camcamfresh/Xiaomi-M365-BLE-Controller-Replacement/(threads)

Thread 1 (2018-08-11):

Question about the pinout to the Particle

pilotdeveloper, 2018-08-11:
How are you connecting this to your particle board?

I've got one and am able to test it too :)

camcamfresh, 2018-08-11:
turn on half duplex mode on the particle board, connect the yellow data wire from scooter to the serial's TX line and make sure to connect the ground too! after that it should programming like any normal system.

pilotdeveloper, 2018-08-11:
No need for a pull-up resistor and connection to RX?

Also, I'm going to open a branch with some additional screen support.

camcamfresh, 2018-08-12:
That's a good question. I'm not too sure. To the best of my knowledge it is not necessary, but I might be wrong. I think the pull up/down resistor just prevents unwanted noise when the line is not in use like during a reset or something. Although since it uses half duplex, the data line might "reset" between transmit and receive. If that is the case, it might be a major problem.

As of yet I haven't had any problems receiving or transmitting data, but I have not switched between receiving and transmitting data while in the main loop. I'll find out soon if it is required. If it is a problem, I think I will connect a 10 ohm resistor between the rx and tx lines.

neo3k, 2018-08-22:
Hi. I'm trying to make the connection, but I can't get it to work. Can you show me a picture of how you did it?  Thank you very much

camcamfresh, 2018-08-31:
I'll add a section in the README about how I connected it.

camcamfresh, 2018-09-01:
I added a part hardware implementation, which explains how I have it wired (with a transistor) and how to wire it if you only need the data communication.

Closed 2018-09-17.

Thread 2 (2018-08-16):

Serial vs BLE Protocol

losnir, 2018-08-16:
Hi!
First, thanks for the well detailed and coherent information, it will be of great use to me (:

Just making sure I understand correctly - the Serial 1-Wire protocol is exactly the same as the Bluetooth protocol (reverse engineered by CamiAlfa)?

My goal is to completely replace the original motor controller & BMS, but keep the the head (BLE) unit, so it will still look and behave like a stock scooter . 😁

camcamfresh, 2018-08-31:
I'm not too sure about the Serial 1-Wire protocol, though I have heard of it. I am pretty sure that the 1-Wire communication protocol is somewhat different than half-duplex serial communication, which also uses one (data) wire.

To the best of my understanding, the Bluetooth protocol reverse engineered by CamiAlfa (which has helped me a lot) is a packet protocol which could theoretically be sent via the 1-Wire protocol.

What are you trying to accomplish by replacing the original motor controller/BMS?

losnir, 2018-09-05:
The reason I'm replacing the electronics is that I'm upgrading to a 60V version of the scooter, possibly a dual-drive in the future.

Maybe I'm mistaken, I thought the data bus between the BLE and DRV is 1-Wire - is it half-duplex serial?

In other words, the communication between BLE/DRV over serial uses the same BLE protocol (`|x55|xAA| L | D | T | c |...|ck0|ck1|`)?

camcamfresh, 2018-10-26:
Sorry for the late reply,
I have only had success with the half-duplex serial.
And the communication over serial uses the same BLE protocol.

sigmounte, 2018-10-26:
In my case , spying on the serial protocol ( not one wire , just TTL half duplex ) , i see protocol who look pretty the same , biggest different is the CRC , it only finish with FE or FF in my case.
I'm waiting also trying to make a full replacement controller , to enable the use of a dual motor with two original Motor/ESC/Battery , piloted by one arduino

camcamfresh, 2018-11-07:
Hmmm... for the CRC I'm thinking that the byte before the FE or FF is also included in the CRC. I'd have to see what data your receiving to tell you more.

As for replacing the motor controller, that seems very daunting. I'm not very good with understanding the electrical parts of the scooter (ha), but this is why I didn't use any resistors on my first prototype of the BLE controller.

Replacing the actual motor controller would seem to require you monitor how the BLDC motor is powered since to the best of my knowledge the three big wires switch rapidly between hot and ground (while the other is off). For example, if you have three wire A B and C: A could be ground for one cycle (where is a cycle is not necessarily a full rotation of the wheel, it could be 1/12 of a rotation or something like that) while B is the hot. The next cycle could have C as ground and A as hot. So you would first have to figure out the correct order in which the three big wires power the motor.

On top of all of that you would also have to monitor the position of the motor (using the 5 smaller wires) to ensure that you do not apply power to the wheel when it is not in the correct position. If you do not monitor the position of the wheel and somehow the wheel is in the wrong position, it would likely lead to the motor burning out or not functioning correctly. I think this becomes a lot more important when attempting to suddenly stop or perhaps speed up.

This youtube video may give you a better idea of what I think you would have to do: https://www.youtube.com/watch?v=W9IHEqlGG1s&t=515s

It might be easier to purchase a second factory motor controller and connect that to a different serial port on the Particle Electron. This may or may not require another battery and would possibly require you to flash the motor controller to remove both the program defined speed limit and the hard speed limit on each motor controller (as each motor controller is not only programmed to not exceed specified speed limit but also to not exceed the physical limitations of the motor).

Thread 3 (2018-09-10):

How to activate Scooter

DoidoYo, 2018-09-10:
Hello, what are the expected commands to the motor controller? Does it have to be unlocked first to then start sending break and throttle information? Is the password needed? I'm also trying to build a BLE controller replacement. While I'm able to read the information between the stock BLE and motor controller, I'm having trouble activating the motor and running it with my custom one. Any help is appreciated.

camcamfresh, 2018-10-26:
So I haven't tried enabling the password on the scooter, though I do remember seeing it on the MiHome app. I've tested the break and throttle information and as long as the scooter is on, the BLE controller sends the values, however if the scooter is locked the motor controller will not activate the motor (though it still receives the values). I would avoid using the word activate since the motor controller does need to be activated once to begin working (I'm not sure how this works but some guys in Russia activate the control boards for like $35 I think, if I find the link again I'll tag it on this thread). Now once it the motor control is activated, it will respond to commands sent by the BLE board. It doesn't matter if the motor controller loses power it will stay activated.  When I began experimenting with the communication data I literally copied the exact packets I was monitoring between the factory BLE board and the motor controller and programmed my microchip to send those. As a result, I had to spin the scooter's wheel before turning the microcontroller on (began communicating with the motor controller) but I was able to successfully turn on the motor although it was only at one speed.

jacknab, 2018-11-02:
hi,
I actually been looking for details on how to make my own BLE board for my scooter, I came across your project here on Github - which totally looks like an exciting project to play around with, I didn't finish reading the description/deals.. I spontaneously went for it.. and without any hesitation purchased the Particle Electron cellular kit.
*Question now:  does the scooter still need the BLE board?
I have 2 M365 scooters, one is fully functioning, my second scooter I actually found in this very cluttered thrift store, sticker price was $10.00   -  however after much troubleshooting I have discovered the ble controller board was fried.

camcamfresh you mentioned you programmed your own microcrontroller could I ask what type of components you used?  Was it something Arduino like?

camcamfresh, 2018-11-07:
No it does not need the BLE board. I did purchase a BLE board, but that was strictly for learning about the messages it sends to the scooter's motor controller (that is where I learned about the information request packet structure; it's in the escControl function of firmware.ino).

I completely eliminated the BLE board from the scooter and replaced it with the Particle Electron. It is very similar to Arduino (both use C++ if remember correctly), but it also has cellular capabilities.

microcontroller = particle electron (I also sometimes use it to describe the motor controller and BMS circuit boards). Not sure if this is the correct terminology, but I've never taken a computer science class about any of this so ... that's what I call it for now.

jacknab, 2018-11-07:
awsome i have ordered the particle cellular board however the version that
had gps board was sold out, the board arrivea tomarrow.

anyway of taking aome photos of your project to see its design and wiring.

it be awesome if there was a way to make a replacement ble board that
functioned the same as the original,  i short circuted my ble board last
month when creating a dispay using the arduino mini. a replacement board
found on ebay cost me $141.00 there were many listings for the ble board
but every other listing showed that part out of stock so was forced to buy
the 141.00 -  and when it arrived it took me a whole 10 mins to actually
fry that new board :(  i disxonnected the battery before hand, but there
was still electric current stored in the wiring or it got a small charge
when i rolled the scooter out of my garrage for better lighting..  but the
board touched the handle bar and i head a pop and off to ebay i went again

On Nov 7, 2018 2:17 AM, "camcamfresh" <notifications@github.com> wrote:

No it does not need the BLE board. I did purchase a BLE board, but that was
strictly for learning about the messages it sends to the scooter's motor
controller (that is where I learned about the information request packet
structure; it's in the escControl function of firmware.ino).

I completely eliminated the BLE board from the scooter and replaced it with
the Particle Electron. It is very similar to Arduino (both use C++ if
remember correctly), but it also has cellular capabilities.

microcontroller = particle electron (I also sometimes use it to describe
the motor controller and BMS circuit boards). Not sure if this is the
correct terminology, but I've never taken a computer science class about
any of this so ... that's what I call it for now.

—
You are receiving this because you commented.
Reply to this email directly, view it on GitHub
<https://github.com/camcamfresh/Xiaomi-M365-BLE-Controller-Replacement/issues/3#issuecomment-436557278>,
or mute the thread
<https://github.com/notifications/unsubscribe-auth/ACnEbIK-oPD8u4H36A6f_X8RFpgXXx9xks5usqVEgaJpZM4WiUpt>
.

jacknab, 2018-11-07:
how are u sending commands to the particle board?  i know over celullar but
did u create a simple web page to do this

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

camcamfresh, 2018-11-07:
I usually use the Particle IDE, but am working on a swift program using HTML Post method (check the Particle Documentation). I am having trouble completing the program as I do not own a mac.

jacknab, 2018-11-07:
thanks for the quick response, I see you have also updated your code, just downloaded it - I received my Electron Particle couple hours ago- however its just the Electron it doesn't have gps board, because the site was sold out. As soon as they get them in stock the site will email me and I will purchase it.

I connected the electron to the 4 wires, still need to connect to throttle, light and motor wires.

I tried writing your firmware file to the electron but since I dont have gps its giving me errors, so I am going through and commenting out the gps stuff for the moment.

Arduino: 1.8.7 (Windows 10), Board: "Arduino/Genuino Uno"

sketch_nov07a:1:14: error: expected constructor, destructor, or type conversion before '(' token

 SYSTEM_THREAD(ENABLED);

              ^

C:\Users\chadb\Downloads\Xiaomi-M365-BLE-Controller-Replacement-master (1)\Xiaomi-M365-BLE-Controller-Replacement-master\firmware\sketch_nov07a\sketch_nov07a.ino: In function 'void setup()':

sketch_nov07a:7:5: error: 'Serial1' was not declared in this scope

     Serial1.begin(115200);

     ^

sketch_nov07a:10:5: error: 'Particle' was not declared in this scope

     Particle.function("CloudCommand", cloudCommand);

     ^

sketch_nov07a:19:13: error: 'D0' was not declared in this scope

     pinMode(D0, INPUT);//Power Monitor

             ^

sketch_nov07a:20:13: error: 'D1' was not declared in this scope

     pinMode(D1, OUTPUT);//Power

             ^

sketch_nov07a:21:13: error: 'D2' was not declared in this scope

     pinMode(D2, OUTPUT);//Buzer

             ^

sketch_nov07a:22:13: error: 'D3' was not declared in this scope

     pinMode(D3, OUTPUT);//Red (Lock)

             ^

sketch_nov07a:23:13: error: 'D4' was not declared in this scope

     pinMode(D4, OUTPUT);//Green (Unlock)

             ^

sketch_nov07a:24:13: error: 'D5' was not declared in this scope

     pinMode(D5, OUTPUT);//Blue (Connecting)

             ^

C:\Users\chadb\Downloads\Xiaomi-M365-BLE-Controller-Replacement-master (1)\Xiaomi-M365-BLE-Controller-Replacement-master\firmware\sketch_nov07a\sketch_nov07a.ino: In function 'void escControl()':

sketch_nov07a:68:5: error: 'Serial1' was not declared in this scope

     Serial1.write(motor, sizeof(motor)); delay(10);

     ^

C:\Users\chadb\Downloads\Xiaomi-M365-BLE-Controller-Replacement-master (1)\Xiaomi-M365-BLE-Controller-Replacement-master\firmware\sketch_nov07a\sketch_nov07a.ino: In function 'void escReader()':

sketch_nov07a:136:11: error: 'Serial1' was not declared in this scope

     while(Serial1.available()){

           ^

sketch_nov07a:176:51: error: 'D2' was not declared in this scope

                             if(beep == 0x01) tone(D2, 20, 50);

                                                   ^

sketch_nov07a:177:57: error: 'D2' was not declared in this scope

                             else if(beep == 0x02){ tone(D2, 20, 100); beep = 0x01;}

                                                         ^

sketch_nov07a:178:57: error: 'D2' was not declared in this scope

                             else if(beep == 0x03){ tone(D2, 20, 50); beep = 0x01;}

                                                         ^

sketch_nov07a:192:38: error: 'D2' was not declared in this scope

                                 tone(D2, 20, 5000);

                                      ^

sketch_nov07a:193:33: error: 'Particle' was not declared in this scope

                                 Particle.publish("Alarm", "Alarm Alert!");

                                 ^

C:\Users\chadb\Downloads\Xiaomi-M365-BLE-Controller-Replacement-master (1)\Xiaomi-M365-BLE-Controller-Replacement-master\firmware\sketch_nov07a\sketch_nov07a.ino: In function 'void backgroundProcess()':

sketch_nov07a:213:20: error: 'D0' was not declared in this scope

     if(digitalRead(D0) == LOW){

                    ^

sketch_nov07a:214:22: error: 'D1' was not declared in this scope

         digitalWrite(D1, HIGH);

                      ^

sketch_nov07a:218:25: error: 'Particle' was not declared in this scope

     if(locked == 0x0 && Particle.connected()){

                         ^

sketch_nov07a:219:22: error: 'D3' was not declared in this scope

         digitalWrite(D3, LOW);

                      ^

sketch_nov07a:220:22: error: 'D4' was not declared in this scope

         digitalWrite(D4, HIGH);

                      ^

sketch_nov07a:221:22: error: 'D5' was not declared in this scope

         digitalWrite(D5, LOW);

                      ^

sketch_nov07a:224:22: error: 'D3' was not declared in this scope

         digitalWrite(D3, HIGH);

                      ^

sketch_nov07a:225:22: error: 'D4' was not declared in this scope

         digitalWrite(D4, LOW);

                      ^

sketch_nov07a:226:22: error: 'D5' was not declared in this scope

         digitalWrite(D5, LOW);

                      ^

sketch_nov07a:229:22: error: 'D3' was not declared in this scope

         digitalWrite(D3, LOW);

                      ^

sketch_nov07a:230:22: error: 'D4' was not declared in this scope

         digitalWrite(D4, LOW);

                      ^

sketch_nov07a:231:22: error: 'D5' was not declared in this scope

         digitalWrite(D5, HIGH);

                      ^

sketch_nov07a:234:22: error: 'D3' was not declared in this scope

         digitalWrite(D3, LOW);

                      ^

sketch_nov07a:235:22: error: 'D4' was not declared in this scope

         digitalWrite(D4, LOW);

                      ^

sketch_nov07a:236:22: error: 'D5' was not declared in this scope

         digitalWrite(D5, HIGH);

                      ^

C:\Users\chadb\Downloads\Xiaomi-M365-BLE-Controller-Replacement-master (1)\Xiaomi-M365-BLE-Controller-Replacement-master\firmware\sketch_nov07a\sketch_nov07a.ino: In function 'int cloudCommand(String)':

sketch_nov07a:248:9: error: 'Serial1' was not declared in this scope

         Serial1.write(unlock, sizeof(unlock));

         ^

sketch_nov07a:252:9: error: 'Serial1' was not declared in this scope

         Serial1.write(lock, sizeof(lock));

         ^

sketch_nov07a:256:9: error: 'Serial1' was not declared in this scope

         Serial1.write(tailoff, sizeof(tailoff));

         ^

sketch_nov07a:260:9: error: 'Serial1' was not declared in this scope

         Serial1.write(tailon, sizeof(tailon));

         ^

sketch_nov07a:264:9: error: 'Serial1' was not declared in this scope

         Serial1.write(cruiseoff, sizeof(cruiseoff));

         ^

sketch_nov07a:268:9: error: 'Serial1' was not declared in this scope

         Serial1.write(cruiseon, sizeof(cruiseon));

         ^

sketch_nov07a:272:22: error: 'D1' was not declared in this scope

         digitalWrite(D1, HIGH);

                      ^

sketch_nov07a:278:14: error: 'D2' was not declared in this scope

         tone(D2, 20, 5000);

              ^

exit status 1
expected constructor, destructor, or type conversion before '(' token

This report would have more information with
"Show verbose output during compilation"
option enabled in File -> Preferences.

Closed 2019-04-05.

Thread 4 (2018-09-22):

does this work with Ninebot ES2?

juergengunz, 2018-09-22:
does this work with the Ninebot Segway ES2 Xiaomi Mijia Scooter too?

camcamfresh, 2018-10-26:
I would not know, but since they use the same protocol as other Ninebot devices, I would assume so, but this is merely an assumption.

tommydzierzak, 2019-01-07:
@juergengunz Have you had any luck with the ninebot? I have been trying myself but can't seem to get communication between the particle and the motor driver working.

juergengunz, 2019-01-08:
@tommydzierzak Yes, but the protocol is a little bit different and as far as I know it's not public.

geg58, 2019-01-21:
Can you push your code on github since you got it working?

juergengunz, 2019-01-22:
@geg58 it is not allowed due to contract agreements

Closed 2019-01-22.

Thread 6 (2018-10-06):

Schematics for cabling the one wire bus

sigmounte, 2018-10-06:
How the Particle is wire to keep power is perfectly explained in text , but what about the 1 wire ?

Woud you make a simple schematics ? thanks !

In fact , where do you change the role of the Particle TX pin when you want to receive data ?

camcamfresh, 2018-10-26:
From my understanding, Particle takes care of all of that for you. The only problem I had was clearing the buffer after I sent data (I did this by "if(Serial1.available()) escReader();" in multiple lines after sending the throttle data (throttle and brake values get 1 reply from the motor controller for every 4 messages)

    Serial1.write(motor, sizeof(motor)); delay(10); //Sends control values to scooter.
    Serial1.write(motor, sizeof(motor)); delay(10);
    Serial1.write(motor, sizeof(motor)); delay(10);
    Serial1.write(motor, sizeof(motor)); delay(10);
    if(Serial1.available()) escReader(); //Clears Serial Buffer; it seems to recieve the packets we transmit.
    Serial1.write(motor1, sizeof(motor1)); delay(10); //Sends control values and request X1 structure from scooter.
    if(Serial1.available()) escReader(); //Read X1 Structure from the Scooter.
    Serial1.write(inforequest, sizeof(inforequest)); delay(10); //Sends control values and request scooter trip information.
    if(Serial1.available()) escReader(); //Read scooter trip information.

Closed 2019-07-05.

Thread 7 (2018-10-26):

Brake and throttle are not working (back LED is blinking)

bnurbekov, 2018-10-26:
Hi,

Thank you so much for such a great work - it’s very useful. I was trying to run your code on my board. However, the brake and the throttle are not working in my case. Back LED is blinking 5 times (as if the brake and the throttle were disconnected from the Bluetooth board). I am wondering if I will need to send some additional messages to notify the main board that everything is connected properly. Please could you help me to resolve this issue? Thank you in advance!

camcamfresh, 2018-10-26:
It sounds like the motor controller isn't receiving any data at all. I think I remember, that the scooter would blink 5 times before I started communicating with my micro controller. As a result, I'm inclined to think that the motor controller is always listening for data from the BLE controller. If the BLE controller fails to send values for a few seconds it will activate the blinking until it receives the values. I will update the program on github later today to my current version.

bnurbekov, 2018-10-27:
@camcamfresh Thank you so much! After I flashed the latest code everything started working. Really appreciate your help.

Closed 2018-10-27.

Thread 8 (2018-11-09):

Particle Questions

jacknab, 2018-11-09:
Hi,
I would just like to ask a few questions please.

Does your Particle board come with the GPS module from Particle or are you using a different GPS module with this project?

With your project have you updated the Particle's Device OS?  Just for helpful information could you tell me what version OS your device is working on.

The NMEAGPS library - In a previous comment you stated you use Particle IDE to compile/flash your device, I am unable to locate any library files for NMEAGPS in the IDE software, I have searched google and found the files which I manually copied into the project folder, however I still get errors when trying to compile errors stating it cant file other library files such as Arduino.h and something serial.h  And advice on what I am doing wrong would be grateful.

And my final question.. would you share your Particle APP (which gives you a link that allows others to install your built app saved on the Particle cloud server.

I am willing to donate some $ via paypal for any help... and of course for your hard work your putting into this project.

camcamfresh, 2018-11-12:
No I am using the NEO-M8N GPS; I found it on eBay for like $20. Here's a link to one: https://www.ebay.com/itm/NEO-M8N-Big-Mini-Antenna-Flight-Controller-GPS-Module-for-PIX-APM2-56-APM2-8/202162246324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

The Device OS I have been using has been 0.7.0, but I think it will work on most of their versions.

As for the NMEAGPS library, it is contained within the NeoGPS library. If you include that library in the side bar, you can replace the include NeoGPS library with the NMEAGPS library in your program code (which will use the library within NeoGPS). An easier way might be to 1) search for the NeoGPS library in the community libraries 2) click on it 3) scroll down to examples and select NMEAsimple.ino 4) select the "Use This Example" button 5) replace the code in the example with the code on GitHub (or your code if you have made any adjustments).

I am a little unclear about your last question: I am thinking of the iOS app that I made to control the scooter, however I am not able to share that as I had to return the Mac that I bought to create the app (I had to create the iOS app within Apple's 14 day return policy lol).  If you're asking about the code that the Electron runs on, the main code is posted on this GitHub (the version I use contains the GPS location of my home as I programmed the scooter to turn it's lights off and unlock when I arrive home).

Also, my Serial1 port broke on my Electron two days ago, so I am working with Particle to get a replacement. I may not be able to test your program for a week or two while I get a new one, though I still need to check for other Serial ports on the Electron to see if they are capable of half duplex mode.

camcamfresh, 2018-11-12:
https://drive.google.com/file/d/1jjfAUqVoqd4QdQPzS_AQ4LxbmgaDKu9f/view?usp=sharing

jacknab, 2018-11-14:
i did finally get it to write the firmware. question - i see the last line of code mentions gps valid = V or I, I believe this code here:  (is what you were mentioning in above comment about for your home location.

if(fix.valid.location){
                gpsUrl = "https://maps.google.com/?q=" + String(fix.latitude(), 6) + "," + String(fix.longitude(), 6);
                gpsValid = "V";
                if((String(fix.latitude()).startsWith("**.***") || String(fix.latitude()).startsWith("**.***")) && String(fix.longitude()).startsWith("-97.727")){
                    headPowerCommand = 0;
                }
                else if(lockCommand == 0){
                    ledPowerCommand = 1;
                    digitalWrite(D6, HIGH);
                }
                else{
                    ledPowerCommand = 1;
                    digitalWrite(D6, LOW);
                }
            }
            else{
                gpsValid = "I";
            }
        }

also the other files not the firmware.ino file do they need to be added when compiling the code?

camcamfresh, 2018-11-15:
The other files are to help with troubleshooting.

camcamfresh, 2018-11-25:
The switch from A3 & A4 to A0 & A1 is just for organization. They are connected to the throttle and brake sensors (blue and green wires). No transistor is used on the throttle or brake.
In order for the motor to turn on, the front wheel needs to be moving at a certain speed. I usually use the brake throttle to see if the scooter is receiving data since the brake light will always respond even if the front wheel is not moving.

Closed 2018-12-10.

Thread 9 (2018-11-18):

bit shifting instead of strings....

smartinick, 2018-11-18:
Not an issue, but as it seems you need to figure that out.... use it like that:

uint16_t crc = (motor1[2] + motor1[3] + motor1[4] + motor1[5] + motor1[6] + motor1[7] + motor1[8] + motor1[9] + motor1[10] + motor1[11] + motor1[12]) ^ 0xFFFF;
motor1[13] = (uint8_t)(crc&0xff);
motor1[14] = (uint8_t)((crc&0xff00)>>8);

maybe that safe you some time - your code templated saved my time (doing similar with the esp32).
Thanks for sharing!

for switching eco/normal mode you can look in my code, m365.cpp, method m365_sendcommand.

camcamfresh, 2018-12-10:
Thank you! My friend recommended that I do this, but my microchip broke before I could test if would work. I'll try replacing my code with this when I finish making my wire harness (probably next week).

smartinick, 2018-12-10:
you are welcome. thanks for starting this repo, saved me some time to
research myself :D
if you have any questions - ideas - i'm happy to give feedback/help!

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

Closed 2019-07-05.

Thread 10 (2018-11-19):

How to turn on controller?

NickGoumas, 2018-11-19:
I have the BLDC motor wheel, battery pack and motor controller from an original scooter. I'm trying to simply send a signal to the controller from a microcontroller. How do I turn on the controller to get it ready to start accepting messages? On the controller board there is a 4 pin connector with labels on the PCB. From top to bottom the labels are "G - T - P - 5". "G" and "5" are ground and 5v while I believe "T" is the data line for communication to the BLE which is normally in the handlebar. "P" seems like some sort of power button but I can't seem to get the controller to stay ON. If I connect 5v to "P" momentarily  the controller's red LED comes on and the green LED flashes slowly for 35 seconds, then the lights turn off. Any advice?

smartinick, 2018-11-19:
connect a pushbutton between P and G. push it short to turn on, when it's on, push it short oncefor turning on/off light, twice for switching normal/eco mode and push it long for turning the scooter off.

if there's no data sent to the esc, and it will turn off itself after a short while...

jacknab, 2018-11-19:
If you take a small screw driver and touch the 2nd PIN (P Pin) the scooter should turn on.  The P pin is the 40V power which is the green wire.  As for your controller turning off after 35 seconds when it turns off do you hear the beep sound?  Also are you hearing any beep sound when you turn it on?

You mentioned you touched pins 5 and P to get the scooter turned on, touching those 2 pins together will burn out the ble controller (i know from experience) if you touched them together like a quick tap you probably didn't cause any damage to the ble controller, when I burned out my controller I noticed only 2 of the leds on the board would light up and as I kept messing with the board the longer it was powered on I noticed another LED would go out.

Because if the controller isn't connected up correctly the tail light would blink in a set pattern and the controller would beep repeatedly in a set pattern.

I would check the grey controller cable that runs down through the handle bar to the motherboard/battery area.  This would mean disconnect the BLE controller and remove the battery protection cover, and unplug the grey cable from the motherboard and gently pull the cable upwards through the top to remove the entire cable, then inspect the entire cable looking for any cuts into the wiring.. If you do find a cut this could be the cause.

If you are interested in testing something (it would require you to remove the outter layer of the grey cable that runs out of the handlebar and back into the bottom V neck bar to the controller area.
remove a small portion of the grey wire wrap exposing the 4 inner wires (Red, Green, Yellow, Black)

You will want to cut the Green wire, cut small portion of the green wire wrapping so your able to connect the 2 wires back together.

Touch the 2 wires together and turn on your scooter once the scooter is turned on break the connection of the green wires, so they are no longer touching.
If the scooter stays on that means the problem lays within the BLE Controller
If the scooter still powers off the problem is either in the motherboard controller or battery

*cutting the green wire, cuts the 40V power from the BLE which is used to turn on/off the scooter

NickGoumas, 2018-11-19:
So when I short P and G I get the same results. Red LED comes on and green LED flashes for a short time. I'm powering a Particle Photon using the 5v and G pins and and connecting the Photon's TX pin to T on the motor controller. Nothing happens.

I wonder if I'm doing something wrong or possibly the motor controller is bad?

NickGoumas, 2018-11-19:
So I just saw @jacknab comment so I'll explain my setup a bit better. I don't have a full scooter, just the wheel motor, battery pack and motor controller. I don't have the BLE controller or it's wiring harness that would run up to the handlebar.

I don't see anything on the motor controller board that could beep so I'm assuming you're asking if the BLE board is beeping? (Which I don't have so not sure.)

Do I need the BLE controller or is it possible to control the wheel with just a micro? I have a particle photon board that I'm using right now. Thanks!

jacknab, 2018-11-19:
ah,  well i am not sure... i have the particle electron i am not sure if
the 2 boards work the same.

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

jacknab, 2018-11-19:
u say u dont have full scooter... could u take a photo on ur phone and
email to me so i can see your complete wiring setup from battery to
motherboard to the brushless motor, to your photon.

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

jacknab, 2018-11-19:
jacknabvoip@gmail

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

jacknab, 2018-11-20:
I took a photo of the wiring in 1 of my scooters. Just for a reference.

In your code your writing to the photon, do have it set to use serial communication to the A4 pin?

NickGoumas, 2018-11-20:
I'm using the BasicMotorControl in this repo. As I understand it should be reading the throttle value from pin A4 and transmitting the hex string via the Photon's TX pin. Since I'm sending 3.3v to pin A4 it should be reading 3.3/5 = .66 so 66% throttle.

jacknab, 2018-11-20:
So the connections go  - ground (black) -- Yellow (TX) -- Green (40V pwr) -- Red (5V pwr)

looking at your image you have a black wire coming out of the controller that then connects into a green wire to your photon.  I can not tell if that wire is connected into the ground or TX pin on the controller in your photo.

Also another thing to note.. the controller board needs to power where you see the red led light on, before your photon can connect with it via serial

Now like i mentioned I have the Particle Electron, I have been messing around with this code on 1 of my scooters, I believe I had it all set up correctly once - because from the particle cloud page when I requested the variables data it shown me DriveStatus set to 2 (which before was always showing 0) and the LightsOn set to 100 (which before was always showing 0)  I attempted to push the scooter just out into the hall way of my apartment building to test if the throttle was working.. but I didn't make it even close to the door before the breadboard fell to the floor disconnecting all the wiring. I haven't got in the mood to redo all the wiring shit again.

I do not have a gps module connected to my Particle Electron but was able to still get camcamfresh's firmware.ino to flash the Electron.  Have you attempted to use his firmware file on your photon?

NickGoumas, 2018-11-20:
The black wire coming out of the controller connects to a green wire and then connects to ground on the Photon.

I haven't tried the full firmware.ino because I was only interested in running the motor but I'll give that a shot right now. Hopefully that does it.

NickGoumas, 2018-11-20:
Still no luck using "firmware.ino".

What do you mean by "the controller board needs to power where you see the red led light on, before your photon can connect with it via serial"

When I turn on the controller the red light turns on, the green light flashes slowly for 35 seconds, then they both turn off. Does your controller do the same?

jacknab, 2018-11-20:
when reading one of your comments about the controller would show a red led and then green led for couple of seconds. Got me thinking, I have only ever seen that green light come on when I am working with the Particle Electron..  So I wanted to double check - when I turn on my scooter and turn throttle the motor begins spinning.  But the green light never comes on not once at any point from turning the pwer on to using the throttle.  I wonder what the green light is actually connected to.

I took a small video on my phone - but had my phone make the video into animated gif to reduce file size for quicker uploading.
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

jacknab, 2018-11-20:
also if you have troubles compiling and flashing the firmware to your photon, here is a compiled file that I created.
After you download change the file extension from zip to bin.
(in windows explorer under View check the check box "File Name Extension" to show the extention

[firmware.zip](https://github.com/camcamfresh/Xiaomi-M365-BLE-Controller-Replacement/files/2598125/firmware.zip)

jacknab, 2018-11-20:
[firmware.zip](https://github.com/camcamfresh/Xiaomi-M365-BLE-Controller-Replacement/files/2598130/firmware.zip)

jacknab, 2018-11-20:
mine doesnt turn off no.. when I connect the Particle Electron up, the red and green light continues to blink, but it never turns off.

jacknab, 2018-11-20:
after I eat something I will go mess around with that scooter and rewire up the Electron Particle to show you...

NickGoumas, 2018-11-20:
Yeah I think the firmware is flashing fine. I'm using particle's web IDE and it checks and uploads without many errors. The firmware.ino had a couple errors because I didn't have the GPS library but I commented the GPS function out and it seemed fine. After flashing I would at least get the "ScooterOff" message from the particle dashboard.

jacknab, 2018-11-20:
do you have a way to see the variables and write to the CloudCommand function?

If so type "poweron"  or "reset" and see what happens.

jacknab, 2018-11-20:
by just commenting out the GPS library you still should of got some errors, as the code calls some of the GPS library functions.  without the library you should get several errors about the library functions not being defined.

NickGoumas, 2018-11-20:
Oh I originally thought he was just using the transistor to control the headlight. It looks like he's using digital pin 0 to control a transistor to short the 40v pin and ground, and this is keeping the motor controller on.

jacknab, 2018-11-20:
correct.

jacknab, 2018-11-20:
I am wiring up my electron right now.. I need to dig out another transistor.. and fiddle around with connecting that up, because I can't remember how I had it wired last time that seemed to been working.

jacknab, 2018-11-20:
I live in Denver, Colorado USA - there are thousands of these scooters through out the city.. almost every block corner has at least 2 parked.  There are several companys that own them - as they offer scooter rental for 0.15 cents a min.

I am a charger for Bird - were I get paid to go pick up scooters that need to be charged. I first started out as a mechanic for them but there was 0 money in that.. so switched to be a charger.. but when I was a mechanic I had access to there storage nest. which was just a small office space in a small office building close to downtown, the app would send a code to the office door which unlocked it, when I was a mechanic there was a section of the office were we dropped off damaged scooter that would be pushed into a truck and taken to the city dump.. after I learned this I took a few scooters that were in pretty good shape and build me 4 good working scooters.  FREE ;)

NickGoumas, 2018-11-20:
That's awesome. I'm out on the east coast myself.

jacknab, 2018-11-20:
Bird is moving slowly out there.. I think they are only in Richmond VA and Raleigh NC so far.

jacknab, 2018-11-20:
here is a diagram he has drawn, when I asked him if he could take a picture of how he was wiring up the transistor.  In his drawing he shows something that uses Pins A1 and A0 he hasnt responded yet to what those pins are used for.

https://drive.google.com/file/d/1jjfAUqVoqd4QdQPzS_AQ4LxbmgaDKu9f/view

NickGoumas, 2018-11-20:
In the code it's A3 and A4, maybe he just mislabeled them in his drawing? I would guess they're the potentiometers that supply a voltage range to the brake and throttle. 0-5v range representing 0-100% brake or throttle.

jacknab, 2018-11-20:
hey what happens when you connect the USB cable to the photon.. does the controller still power off?

camcamfresh, 2018-11-20:
So I have been talking with Particle about getting a new Electron. In the meantime I’ve been working with a Photon on the scooter and the Serial1 port is not working properly. I had to disconnect the Photons onboard led light to get to Serial2, and then it started working. I’m talking with some people on the particle forums to see if It is a software issue.
For the picture, A0 and A1 just replace the A3 and A4 on firmware.ino
A few tips also: when the scooter is powered on it will show the red light on the motor controller.
If the scooter doesn’t receive any serial communication the green light and the brake light will flash about every second. If the scooter receives serial data but doesn’t connect to the brake or throttle it will flash three times on the green light and brake.
If the 40V power is constantly shorted with ground, then the scooter will not blink at all. Instead only the red power light will stay on and resets every few seconds.

jacknab, 2018-11-20:
I actually read on there site in 1 of there documentations that you had to disconnect the led light...

jacknab, 2018-11-20:
I am trying to figure out how to get the electron to do a force handshake, I been having troubles connecting to the cell towers, in the particle console says session is outdated.   It seems like when I reset or disconnect the battery and reconnect it - it would refresh the handshake etc.

NickGoumas, 2018-11-24:
Can anyone verify they've been able to run the motor of the scooter using only a separate micro (particle, arduino etc) without the handlebar board involved at all? I'm wondering if that board is doing something that's being missed here. Unlocking or activating the motor controller somehow.

smartinick, 2018-12-05:
> Can anyone verify they've been able to run the motor of the scooter using only a separate micro (particle, arduino etc) without the handlebar board involved at all? I'm wondering if that board is doing something that's being missed here. Unlocking or activating the motor controller somehow.

i can confirm - esp32

DoidoYo, 2018-12-05:
I’ve used both esp32 and Arduino to run the motor

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

NickGoumas, 2018-12-05:
@DoidoYo which arduino are you using? I'd much rather use an arduino but I didn't think they supported half duplex out of the box.

smartinick, 2018-12-06:
half duplex or not is no problem, if no halfduplex either use softserial on a single pin, or the external resistor/diode "trick".

it's more the problem about sending packets within the correct timing and correct values - e.g. my scooter does not accept the min-throttle  values used in this project, if i raise that value by 2, it works.

and then it depends what else you want to do with your micro, e.g. a single-core micro that has no dma-functions will have problems doing long-time-consuming i2c display updates while maintining the correct timing for the uart/esc packets.

so if it's "only" to replace the ble-module, no wifi/ble connectivity, no display needed.... some atmega-based arduino will make no problems at all...

BPitts2, 2018-12-09:
I'm also having issues with just getting an my Arduino Uno to do motor control. I have been playing with the basic motor control code segment.

Here's what I've been trying to do:
I briefly bridge 40v (green wire) to ground (black wire). This causes the scooter to appear to turn on. Red LED on the motor controller turns on, green led flashes once every 2 seconds. Tail light also flashes at the same time as green led.
While the scooter appears to be "on", I am writing the unlock request to the single wire serial.
After writing the unlock, the motor and motorl are written to the serial.

However, the motor controller eventually shuts off and both the red led and green (flashing) led stop. The tail light also stops. It appears the motor controller didn't receive something it wanted to stay awake.

As mentioned above, I found that the map was not correct for my scooter either, so I obtained the minimums and maximums of my throttle and brake levers and corrected the map min/max ints. This hasn't helped yet, but I know it was needed because the analog read values wouldn't have been valid in the map anyway. So that's probably a step further than I need to be right now.

What I'm trying to understand is after the motor controller is "on", what is the next command or sequence that needs to happen to keep it awake and ready to receive motor controls?

FYI - My pin 1 TX is connected to the yellow wire (which I understand to be the data signal cable) I have not been as worried about the half-duplex serial because I didn't see anything in the basic motor control that required me to listen to the serial bus. Thus, I have NOT implemented anything other than the basic arduino serial.

BPitts2, 2018-12-09:
If anyone has an implementation of basic motor control for an Arduino, I'd like to see the code if you don't mind sharing please!

BPitts2, 2018-12-10:
Scratch that - I was able to get it up and going on an Arduino Uno! Still working out some kinks, but yes, this works. My issue was a bad ground.

NickGoumas, 2018-12-10:
@BPitts2 that's great news. Did you change the code at all? Using the TX pin or a digital pin with software serial? What are you using for you map values?

I have an Uno at hand and I'm really interested in seeing if I can copy your results. Thanks.

BPitts2, 2018-12-10:
Yes - I had to make a few modifications to the code. I have implemented lock and unlock, as well as tail on and tail off.

I really need to draw up a schematic so that it's easier to understand where everything goes. Basically, I am continuing to use the basic Arduino serial RX port. Either I will have to implement soft serial, or use a hardware trick with a diode if I want to READ any data from the scooter. This is a "next step" for me.

I have adjusted my map values, but this is something that still needs a little work. I don't think I'm getting full throttle. Overall, the throttle is a little wonky. It works, but I feel like something isn't all the way there.

I will probably fork this and upload what I've done for the Arduino Uno. I have a couple more interesting ideas that I want to play with. One of them is unlocking the scooter using my RFID fob.

camcamfresh, 2018-12-10:
I got a replacement Electron from Particle, and now I can begin working with the scooter again. I'm probably going to add more info to the README file later in the week and I'll try to include pictures of how I have my Electron connected.

> Oh I originally thought he was just using the transistor to control the headlight. It looks like he's using digital pin 0 to control a transistor to short the 40v pin and ground, and this is keeping the motor controller on.
>
I use two transistors in my set up. One to short the 40V pin and ground when activated, the other connects the headlight's buck converter to the 5V power line when activated (turning the headlight on).
> I have adjusted my map values, but this is something that still needs a little work. I don't think I'm getting full throttle. Overall, the throttle is a little wonky. It works, but I feel like something isn't all the way there.
>
I had a problem with the throttle in the past. The motor would be off when the throttle wasn't pressed, and the motor would go to full speed if the throttle was pressed in any way. I'm not exactly sure where the error was, but rewrote the program and believe I have fixed the issue. I need to polish the code up before posting it (I'll try to do that this week after my finals).

smartinick, 2018-12-10:
> I use two transistors in my set up. One to short the 40V pin and ground when activated, the other connects the headlight's buck converter to the 5V power line when activated (turning the headlight on).
which buck converter do you use?
need a working type for my pcb to make :D

camcamfresh, 2018-12-11:
I use the Icstation MT3608. It is a variable boost converter that I got off amazon.

smartinick, 2018-12-13:
> I use the Icstation MT3608. It is a variable boost converter that I got off amazon.

thanks for the info! and it works with that? i thought there should be some constant current regulation as well?

vickyfikria, 2019-01-03:
Hello everyone, I have same problem with Electron-as replacement- setup.
I already follow @smartinick diode trick, but still couldn't got any reply from motor controller. With diode trick, we comment this line , Serial1.halfduplex(true); // right ?
or should I use  Serial1.halfduplex(false);
I have question Mr @camcamfresh , My Electron firmware is v.0.7.0, is this the correct version ? Thanks before

vickyfikria, 2019-01-09:
I'm trying to duplicate your work with Electron. But when I monitor scooter protocol with logic analyzer

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
it is 5A A5 xx xx xx xx, not 0x55 0xAA xx xx . Any idea ?

flashmax1235, 2019-02-24:
Hi,

I am very interest in your work but I do not have a particle board, only an UNO and a MEGA.  @BPitts2 Could you upload your arduino code that you go to work?

Best,
Maxwell

nonsintetic, 2019-02-25:
Hi guys, I have to design a prototype controller and firmware for the m365 for WORK.
It's a scooter rental company that wants to make their own controllers. I will have access to 400 scooters, spare parts, budget etc. If you guys need anything tested, starting next week I will be working on this a lot. First trying to get what you guys have done working, then extending everything to be as perfect as it can.
End goal is a 3G mobile internet + GPS + accelerometer controller, probably based on the esp32. Fully configurable with an API for setting all custom params, all open source of course.
I'm going to be looking into the various firmwares people flash to the motor controller, having a stable one that we can just flash to any motor controller would help a lot with getting consistent results.

kdconocchioli, 2019-03-03:
@BPitts2 I'm doing the same setup you did with the motor, motor controller, battery, and arduino uno. I was wondering though what you did to simulate the brake sensor and throttle sensor analog inputs.

Also, if you'd be willing to share your Arduino code, that'd be really awesome.

doomsday425, 2020-11-29:
Good afternoon I’ve recently purchased a xiaomi m365 pro (second hand). I’ve recently changed a new front motor to the scooter as the front one was damaged. I’ve came across a problem where the wheel won’t work and the controller has a steady red light that won’t turn itself off after a while unless you power down the scooter. There’s no green flashing lights nor bleeping sounds. The battery holds between 40-50v.

Much appreciated,
Doomsday425

alekxoo, 2021-07-10:
@doomsday425 @kdconocchioli @flashmax1235
Hello, was wondering if you guys been able to get a working Arduino code and if so if you could share it with me that'd be really great! Thank you. alexkoo@utexas.edu

kdconocchioli, 2021-07-10:
@alekxoo are you part of the hyperloop team at UT? It was a pretty simple wiring (that I can't remember) but required touching the high vtage line to one of the small voltage lines to turn on. Really weird but I'll see if one of my old colleagues can message back with the wiring.

kdconocchioli, 2021-07-10:
If you can find Eric tang at utexas he got it working for sure and may still have the code!

Thread 11 (2018-11-25):

Particle Electron/Photon Serial1 Error

camcamfresh, 2018-11-25:
So I have ran into a big problem attempting to communicate with the scooter using Serial1 on the Photon and Electron. The problem is that Serial1 will not transmit data on half duplex mode. I am currently waiting for some replacement devices to finish debugging the problem. I am also talking with some contributors at Particle as it seems to be a problem with the device itself, perhaps a system firmware update.

For now, I have been able to bypass Serial1 altogether and use Serial2 (however this requires interfering with Particle's onboard RGB LED). The following link should provide instruction for enabling Serial2: https://docs.particle.io/support/particle-devices-faq/photon-serial2-faq/
When enabling Serial2, I did not remove the onboard RGB LED nor the current limiting resistor. I merely connected a wire to Serial2's Tx (green led) and added "#include "Serial2/Serial2.h"".
If you have a Particle Electron, switching to Serial4 or Serial5 would be preferable.

camcamfresh, 2018-12-10:
Received a new Electron this past weekend. Half duplex is working again. I'm not entirely sure, but I think it may have been an issue with the device itself. I'm afraid to upgrade the system firmware (of the Particle devices) as I have a problem downgrading it back to the system firmware that I know works (0.7.0).

Closed 2018-12-10.

Thread 12 (2018-12-14):

Control two ESCs from one stock (or other) Controller?

galstaf, 2018-12-14:
This project is in the same ballpark as what I am trying to do, so looking for some input from those who have way more knowledge than me. I have an M365 and that got me interested in the Bird scooters. I became a charger and briefly a mechanic (although that was frustrating), so now I just stick to the charging.
Via my mechanic friends, I got a bunch of parts that Bird were dumping in the trash so I have a built a bench rig up with 2 motor wheels, 2 ESCs and 2 batteries packs.

I am not sure I need the cellular capabilities of the Particle Electron.. If anything I would like to use the stock BLE board and speed controlling rheostat switch on the stock scooter to control *both* ESCs and Both wheels to run at the same speed and power at the same time.
I want to do this to build an two wheel drive scooter with a new custom body.

Would it be as simple as splicing the TX wire off and running it to the second ESC? From what I understand from this project, this is how the wires go...
ground (black) -- Yellow (TX) -- Green (40V pwr) -- Red (5V pwr)

It seems like there may be an issue with the BLE board getting communication from two ESCs, but perhaps not?

Can anyone help here? What would be the best way to address this and achieve my goal of one throttle control switch controlling two wheels at the same time?

BPitts2, 2018-12-14:
If you don't care to RX any info, you'll probably be fine. I haven't went
deep enough to have a consideration for handling messages from two machines
at the same time.

I don't see a reason that you couldn't at least have dual motor control
from one BLE replacement on one communication bus.

I also have two units at home. Now I'm really interested in making a 4
wheeled electric go-kart of some sort....

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

galstaf, 2018-12-14:
> If you don't care to RX any info, you'll probably be fine. I haven't went deep enough to have a consideration for handling messages from two machines at the same time. I don't see a reason that you couldn't at least have dual motor control from one BLE replacement on one communication bus. I also have two units at home. Now I'm really interested in making a 4 wheeled electric go-kart of some sort....

Right? That sounds awesome too!

However, it would be nice to get the RX info from at least one of the ESC units for speed and battery remaining information. I don't know how the BLE board would handle input from two ESCs at once. However it may be interesting to just try it and find out.

Does anyone else have any thoughts on this?

galstaf, 2018-12-18:
PARTIAL SUCCESS!

Just some feedback on using the stock BLE ... I tried controlling the two ESCs by splicing into the control wiring. With a little thought, obviously one cannot just connect the yellow, because the ESC requires the 40V and ground to tell it to turn on and off. It turns out  also it needs the 5V for something otherwise the motor will not activate... not entirely sure what the 5V is used for tho.
So all 4 wires need to be connected to both of the ESC units.

The flashed Botox firmware was then applied to both ESC units separately. Can anyone tell me if the firmware is applied at the BLE level or the ESC level or both?

ISSUES WITH THIS SOLUTION:

- You can connect the control software (I use M365 Tools), but it is obviously super confused as it is getting data from both of the ESC units, so the battery serial number and other data will randomly change.  It also doesn't show the speed correctly so it is pretty worthless.

- The above issue is not a big deal, as in testing, both wheels worked together, but then randomly one of the ESCs will hang and the wheel will stop if the app is connected. So connecting the app will cause only drive wheel to eventually fail and stop. The ESC will stop responding to commands and has to be unplugged from the battery to reset it.

- The ESCs do not respond to a power off command (long press shut off). It will go off for a second and then come back on again. The only way to effectively shut down the ESCs is to disconnect battery power
I think I am going to have create a physical power off switch to disconnect both the scooters from their batteries so I can shut it down.

So it is kinda working, but not great. Still looking for suggestions on a better solution.

camcamfresh, 2019-02-19:
Firmware for like the hard speed limit and throttle control reside within the motor controller's firmware, but it's usually flashed through the microcontroller.

For your third bullet point, have you tried changing the timing of the poweroff command? also if you're using your own microcontroller, make sure the usb power isn't turning the scooter back on again.

galstaf, 2019-02-19:
It is a factory BLE (microcontroller as you call it)... the long press shutdown command doesn't seem to work with multiple ESCs connected. I think short of making a controller, the only resolution is to have a manual power switch to kill power to all the ESCs.

On further testing, you are correct.. the firmware lives on the ESC, not the BLE. I can swap BLE boards and the same firmware is still on there.

Thanks again for your input!

LeRaphael, 2019-09-09:
Hello
 i make Xiaomi M365 with 2 Motors and add Towing with 2 motor (Total road 4 Motor) I want use Arduino between the controllers and the display for dispatch information

exemple :
BLE - > Arduino -> ESC 1
                           -> ESC 2
                           -> ESC 3
                           -> ESC 4
 or

BLE - > Arduino -> ESC 1
                           -> ESC 2
                           -> Arduino -> ESC 3
                                              -> ESC 4

i try with 2 ESC and one BLE with Data line connected with Y its working for Throttle and brake (down information), but for power on, turn on light, battery indicator and eco mode, and all ESC to BLE communication its not good (Up Information)
for this i want use Arduino for intercept up and down information and send or resend just what I need

You can help me ? you have finish your project ?

Sorry i'm french my English is not good

thomz0r, 2020-05-26:
funny , i was googling to find an arduino implentation and found that projet , i have in mind exactly the same goal .  i think best is to. drive natively both ESC and even add the abbility to enable it .
i will try to port the dev on arduino only , no need GPS , not even BT .

bartoszwarszawa, 2020-06-03:
I think it would be the best to use boards like ESP with dual thread functionality as the timings on sending and reciving messages from drv controller is quite delicate and can't be disturbed by other processes. I already succeed in recreating the project with ESP32 and SIM808 GSM module instead of Proton board

Thread 13 (2019-01-28):

"Motor Control" vs "firmware"

Teklock, 2019-01-28:
Does anyone else have throttle issues with firmware.ino?  It's very strange but in short it don't work.  However when I build a firmware out of "Motor Control"  Everything works perfect!

BPitts2, 2019-01-28:
Have you reviewed the map, and also checked your grounds? I had to update
the map settings for my throttle, it was slightly higher than the existing
code. I also had an issue with a stray ground wire that was causing chaos.

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

Teklock, 2019-01-28:
I'm glad you asked this!  How do I find the limits for the throttle?

BPitts2, 2019-01-28:
I think I wrote a basic sketch to just read the input from the throttle and
print to serial. Then I took the min and max values and updated the map.

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

camcamfresh, 2019-02-03:
The factory halls sensors take an input 5V (you could use 3.3V), but the Electron’s pins are 5V tolerant.

BPitts2, 2019-02-03:
Camcamfresh is correct:

Notes: [1] FT = 5.0V tolerant pins. All pins except A3 and DAC are 5V
tolerant (when not in analog mode). If used as a 5V input the
pull-up/pull-down resistor must be disabled.

https://docs.particle.io/datasheets/cellular/electron-datasheet/

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

Teklock, 2019-02-04:
I understand the pins are 5v tolerant, but from what I've read on their forums ADC reference voltage comes from the 3.3v supply.  I guess for me to better understand, can you explain this line of code.

map(value, 685, 4095, 0x26, 0xC2)

I'm guessing the 4095 is the max (12bit) and 685 is the min?

BPitts2, 2019-02-04:
Yes, that is the analog input from min to max and mapping to the min and
max Hex codes. I didn't dig much deeper, but my assumption is that the
motor controller is expecting input from a min to max range. In order to
have a consistent throttle curve, the analog input is mapped to the min and
max Hex.

Anyone feel free to correct me if I'm wrong.

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

Teklock, 2019-02-04:
So why is the min 685 when there is no voltage?  Shouldn't it be 0?

Teklock, 2019-02-04:
Also why would the ESC expect a range from 38 to 194.  Where does that range come from?

camcamfresh, 2019-02-06:
> Yes, that is the analog input from min to max and mapping to the min and max Hex codes. I didn't dig much deeper, but my assumption is that the motor controller is expecting input from a min to max range. In order to have a consistent throttle curve, the analog input is mapped to the min and max Hex. Anyone feel free to correct me if I'm wrong.
>
From what I remember, the motor controller's minimum acceptable value is 0x26. Anything below that, say 0x00, would cause the motor controller to think that the sensor isn't connected. I do think there is a maximum value for the motor controller too (e.g., it won't accept 0xFF), but I don't remember the exact value something like 0xF0. The above applies to both the brake and throttle sensor.

> Also why would the ESC expect a range from 38 to 194. Where does that range come from?
>
I'm not entirely sure on that. My best guess is that the minimum value ensures that the sensor is connected; for example, if the sensor wires were disconnected the microcontroller could read 0x0 or a smaller value (idk maybe from static from the air or case) like 0x15. As for the maximum value probably the same reason; for example, if the sensor wires were shorted, the sensor could send back 0xFF. This is just a guess though.

Teklock, 2019-02-06:
Makes sense, ty sir!

fyi... I have the throttle working very nicely on a teensy 3.1 with:

map(control, 900, 4095, 0x26, 0xCC);

after you enable 12bit with:

analogReadRes(12);

Closed 2019-02-19.

Thread 15 (2019-02-18):

How to receive data from Motor controller and BMS?

kyuhyong, 2019-02-18:
Thank you for the detailed information as they are very clear and well documented.
One thing I noticed is that the board can send message through TX port but how it can receive data from the motor controller and BMS? since there is no RX port for it.
Isn't half duplex serial communication still needs both RX/TX ports for receiving and transmitting data?

camcamfresh, 2019-02-19:
I was very confused about the communication when I first started and I'm still not sure I completely understand it. I think you're thinking of simplex, which is data communication one way only.

With the scooter, data is transferred via one data wire (plus the ground) that connects to the motor controller, BMS and microcontroller. All three devices talk to each other on the same data line (and share a ground).

When you enable half duplex _mode_ on the Particle device it connects the Rx and Tx line together via an onboard resistor or transistor (maybe both I'm not too sure) and tells the Particle device to only send or receive data, but not both at the same time.

As a result, only one wire is used at a single moment. If we speed the communication up to say 115200 bauds, we can fit the Tx and Rx on the same line by switching between the two modes really fast. Particle handles this all in there library, so all we have to do is program the communication protocol.

Thread 16 (2019-02-22):

What boost converter for headlight control?

kyuhyong, 2019-02-22:
I saw it drives headlight by boosting vcc 5.0V to 6.3V across the headlight unit.
Can you share what kind of parts did you use for it?

kyuhyong, 2019-02-27:
I figured out this myself.

Closed 2019-02-27.

Thread 17 (2019-03-01):

How to reset the scooter? I cannot turn it off.

kyuhyong, 2019-03-01:
I did check the scooter is under control of particle electron for a while and have been testing.
Unfortunately I forgot to unplug the usb connector and send command to power off through cloud.
Then it won't turn off the scooter nor can command it even after usb disconnected.
Now 5V power is always on and cannot read tx data from either BMS or ESC.
I manually short 40V to Ground with no luck.
I am desperate to know if there is a way to force reset the whole system. Please help.

kyuhyong, 2019-03-01:
I solved this issue by opening the bottom plate and unplug the power connector as seen here.
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

camcamfresh, 2019-03-04:
I had that same issue a few times with mine. Apparently the motor controller goes into an error state long enough to refuse communicating with the microcontroller. Do you know how to recreate the problem? I haven't had that problem in a while but want to be prepared for it.

nielswalther, 2020-01-18:
Hi  kyuhyong
Thanks Man, my son and I have just tried to install the Xiaomi pro dashbord, and it did not work, so we installed the old dashbord again, but now it was not possible to turn the scooter off and we could not connect to the app either. Your Fix solved the problem, so now I have a happy son and a working scooter again. THANKS!

Closed 2019-03-01.

Thread 18 (2019-03-08):

Why my drive status is always 0?

kyuhyong, 2019-03-08:
Now I can turn on/off, lock/unlock the scooter with cloud api however I cannot actually turn on the motor.
I see serial transmission going in the TX line.
However the DriveStatus variable always return 0
Is there anything I can do to solve this issue?

camcamfresh, 2019-03-08:
drive status is 0 for off, 1 for wheel movement, 2 eco on (wheel off), 3 eco on (wheel movement).

The motor will only move when drive status is 1 or 3.

kyuhyong, 2019-03-09:
Hi @camcamfresh Is there a way I can set the drive status other than 0?

Closed 2019-04-03.

Thread 19 (2019-03-11):

Can i prevent from sleepmode When locked?

softmarshmallow, 2019-03-11:
https://www.reddit.com/r/ElectricKickScooters/comments/928ccm/is_it_possible_to_disable_m365_es2_sleep_mode/

Same problem with this,
To quote.
>If I didn't ride scooter in couple of hours, then M365 / ES2 powers off automatically even it's locked(M365: 3 hours, ES2:
1 hour). After that, If I power it on again, then it's unlocked. I want my scooter keep lock mode and prevent to sleep even after 3 hours. Is there any way? Please share me some link, products or custom firmware which can handle this problem. Thanks.

AMHenriques, 2019-03-11:
if you are using a micro controller you could unlock and lock the scooter each hour, it only takes less then a second and the scooter resets it's locked timer so the scooter will keep the scooter "always locked"

Thread 21 (2019-03-16):

ES4 BLE Controller

mast3rshak3055, 2019-03-16:
If I shipped you a Segway ES4 could you adapt the code for that model as well?

camcamfresh, 2019-03-16:
Sounds interesting, probably could do, but not until I finish up a few things with my current project. I would also have a few concerns about ensuring it's not stolen.

mast3rshak3055, 2019-05-13:
I could buy one from Amazon and ship directly to you. Also I would love to contribute to the project! Cant wait to see the phone app. Do you have a PayPal or a way to accept a donation?

pilotdeveloper, 2019-05-13:
For what it's worth, I'd be happy to take a stab at it!

camcamfresh, 2019-05-16:
@mast3rshak3055  I've been pretty busy lately; I actually just started working on a CS degree, so I'm not sure how soon I would be able to get the chip to work with the ES4 (if I could at all). I'll know more of what my schedule looks like in about 2 weeks. I would assume it is the same (or very similar) protocol, have you tried connecting to a ES4 yet?

As for the app, I actually haven't really made that many changes to the app since publishing the first version. Although, I did add support for Android Oreo and up. It really isn't that great. I had problems using Particle's Android SDK, so I had to do a lot of things manually. You can check it out on the play store it's called "Scooter Connect" (for lack of a better name). The pin configuration for the software on the app (that is flashed OTA to the M365 microcontroller) is:
```
int brakeInput = A5;
int throttleInput = A4;
int RLED = D5;
int GLED = D4;
int BLED = D3;
int buzzer = D2;
int headlight = D6;
int powerSwitch = D7;
```
The other wiring is the same.
I also added a voltage divider for the brake and throttle inputs which fixed the throttle issues that I was experiencing (so at 3.3V [rather than 5V] the brake/throttle inputs will send the maximum values to the scooter).

Thread 22 (2019-03-16):

Problem receiving responses from M365 when front light is on

fmenendez, 2019-03-16:
Hello,

I write you because I am suffering a very strange issue and I would like to ask you if you have suffered it too, my problem is that I have a applicaction that talks with an M365 using the serial port, after struggling a lot with it I have been able to make it work, I mean, I have been able to send messages to the M365 and receive responses. But a problem has suddenly appear when I have turned on the front light, because if this happens I stop receiving responses from the M365, altough I receive messages none of them are response messages, do you know what the problem could be? If so, do you know how this can be fixed?

Thanks a lot in advance for your reply.

Best regards.

camcamfresh, 2019-03-16:
When you turn the headlight on, is the light intensity constant or does it flutter a bit?

Rosch94, 2019-03-16:
Hey @camcamfresh im currently programming my own project. In project everything works fine. Just one thing, if turn the headlight on it begins to flutter a bit. Do you know the reason ?

fmenendez, 2019-03-17:
Hi @camcamfresh,

First of all, thanks a lot for your quick reply.

Answering your question, the light is constant... but the M365 stops replying...

I give you the Python script I am using to test this issue, maybe you see something wrong in the command or elsewhere:

import serial
import time

while (True):
	ser = serial.Serial();
	ser.baudrate = 115200;
	#ser.port = '/dev/ttyUSB0';
	ser.port = 'COM5';
	ser.parity=serial.PARITY_NONE;
	ser.stopbits=serial.STOPBITS_ONE;
	ser.bytesize=serial.EIGHTBITS;
	ser.timeout=0.05;
	ser.open();
	ser.write("55aa0322011012b7ff".decode('hex'));
	ser.flush();
	s = ser.read(1024);
	ser.close();
	hex = s.encode('hex');
	if (hex.find("55aa1425") != -1):
		print (hex);
	time.sleep(0.01);

If I print all the messsages received from M365, instead of only the reply ones as I do in the script, these are the messages I see when I turn on the light:

55aa07206500042629000020ff55aa0920640006262900007200abfe55aa062164000007640009ff
=================================================
55aa07206500042629000020ff55aa07206500042629000020ff55aa07206500042629000020ff
=================================================
55aa07206500042629000020ff55aa07206500042629000020ff
=================================================
55aa07206500042629000020ff55aa0920640006262900007200abfe55aa062164000007640009ff55aa07206500042629000020ff
=================================================
55aa07206500042629000020ff55aa07206500042629000020ff55aa07206500042629000020ff
=================================================
55aa07206500042629000020ff55aa07206500042629000020ff
=================================================
55aa07206500042629000020ff55aa0920640006262900007200abfe55aa062164000008640008ff55aa07206500042629000020ff
=================================================
0160004403042629000020ff55aa07206500042629000020ff55aa07206500042629000020ff
=================================================
55aa07206500042629000020ff55aa07206500042629000020ff
=================================================
55aa07206500042629000020ff55aa0920640006262900007200abfe55aa062164000008640008ff55aa07206500042629000020ff
=================================================
55aa07206500042629000020ff55aa07206500042629000020ff
=================================================
55aa07206500042629000020ff55aa07206500042629000020ff
=================================================
55aa07206500042629000020ff55aa0920640006262900007200abfe55aa062164000008640008ff55aa07206500042629000020ff
=================================================
55aa07206500042629000020ff55aa07206500042629000020ff
=================================================
55aa07206500042629000020ff55aa07206500042629000020ff
=================================================
55aa07206500042629000020ff55aa0920640006262900007200abfe55aa062164000008640008ff55aa07206500042629000020ff
=================================================
55aa07206500042629000020ff55aa07206500042629000020ff
=================================================
55aa07206500042629000020ff55aa07206500042629000020ff55aa07206500042629000020ff
=================================================
55aa07206500042629000020ff55aa0920640006262900007200abfe55aa062164000008640008ff55aa07206500042629000020ff
=================================================
55aa07206500042629000020ff55aa07206500042629000020ff
=================================================

As you can see I do not receive any message like:

55aa1453f70306038826c98028d8ff474a3138493741323031301501781ecdfb

which means a reply to me request...

Again, thanks a lot for your help!

pradeepnarava, 2019-03-26:
I need this microcontroller ,how can I get it to India?
Any contacts ?
My mail is pnatrial@gmail.com

camcamfresh, 2019-04-05:
@Rosch94 The headlight's intensity could change for many reasons. My initial guess is something is incorrect with the boost converter; you'll probably want to change the output voltage.

@fmenendez take a look at the message after 55aa09... that is a reply from the motor controller, so it looks like its communicating. What do you mean it stops replying? If there is an error light on the scooter then I would first check your throttle/brake values (perhaps the headlight is changing the power supplied to the hall sensor readings and making the read value invalid). Otherwise, I would check the the message parser/reader.

@pradeepnarava The microcontroller used is the Particle Electron; you can purchase a development kit from their website at www.particle.io. You will then need to wire the Electron to the scooter. If you're interested I will probably be finishing a box with everything except the Electron that can be mounted to the M365 scooter; I might be interested in selling it later on (probably on eBay or something). I'll post some details in the project.

pradeepnarava, 2019-04-12:
@camcamfresh Hi,thankyou for replying,what is your mail address?have to discuss with you few important points.

pradeepnarava, 2019-04-13:
Can we use Arduino with SIM?
Do you have Arduino code?

Thread 23 (2019-04-03):

Is there specific reason to send same command multiple time?

kyuhyong, 2019-04-03:
In void escControl(), I see sending same command repeatedly here.
https://github.com/camcamfresh/Xiaomi-M365-BLE-Controller-Replacement/blob/2dd581ccc5f5c46db6ae40c149a34edba7d66131/MotorControl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
Is this for making sure the serial messages not being lost anyway?
Also, why does it need to have motor, and motor1 messages at the same time even though they all look the same.
Thanks,

Kyu

camcamfresh, 2019-04-04:
motor is sent 4 times in an effort to mimic the factory controller.

motor1 is very similar to motor because it is the same message but also requests the motor controller to send data back to the microcontroller (the x1 structure).

motor is sent more often than motor1 because the brake and throttle values need to be sent to the motor controller every few milliseconds, whereas we only need replies from the motor controller every few hundred milliseconds.

kyuhyong, 2019-04-05:
Thank you for such a kind explanation.

Closed 2019-04-05.

Thread 24 (2019-04-04):

Can't get wheel to spin

ir-fuel, 2019-04-04:
Hello
I have your code running successfully on an Electron, and I can communicate with the M365 and send and receive data. Lock and unlock works for example.

What doesn't work however is trying to spin the wheel. I implemented a loop where every second I increase the throttle value being sent in 100 increments from 685 to 4095, whilst keeping the brake value at 685.

What basically happens is: nothing, until I get into a value range that is too high for the controller and then I get the "invalid throttle value error" (green led blinking in a certain pattern on the motherboard). As soon as I restart the counter from 685 that green led stops blinking until I get too high again.

Is there anything else I need to send in order to get the wheel spinning?

Thanks

camcamfresh, 2019-04-05:
the motor controller has safe guards to prevent the motor from turning on without prior movement. I'm pretty sure this is to prevent the motor from burning out. So for the motor to turn on the wheel has to be turning at a certain rate.

This can be reprogrammed by flashing the motor controller via the microcontroller but I wouldn't want to do it with this microcontroller as any errors could result in a bricked motor controller. I would probably use the factory dashboard to change the motor controller firmware. Check out this link: https://m365.botox.bz/

ir-fuel, 2019-04-05:
Ha, silly me. Of course, just as you can't ride the scooter without kicking it to a certain speed.
Thanks!

Closed 2019-07-05.

Thread 25 (2019-04-05):

What is "start"?

ir-fuel, 2019-04-05:
I am trying to understand the code, and I see that upon receiving a certain sequence of bytes, a "start" command is sent

```
unsigned char start[] = {0x55, 0xAA, 0xF, 0x24, 0x1, 0x0, 0x4D, 0x49, 0x53, 0x63, 0x6F, 0x6F, 0x74, 0x65, 0x72, 0x35, 0x32, 0x31, 0x39, 0x85, 0xFB}
```

Can you explain what this does? I see it targets `0x24` which is not listed in the documentation as any of the modules of the scooter. This is sent as a response to a received message of `0x02` length. I have a few docs about the BLE protocol and I don't have any message of that length in there. Could you please tell me what this is for?

Thanks!

camcamfresh, 2019-04-05:
I've learned most of what I have from monitor the communication between the motor controller and factory microcontroller. I haven't seen this command to have any noticeable effect, but I included it in the program because that is what the factory board does everytime it is powered on (perhaps it has something to do with the version number of the motor controller).

Closed 2019-07-05.

Thread 26 (2019-04-08):

Status of Replacement Circuit Board

baldemir, 2019-04-08:
Hello,

First of all thank you for your effort on this project. I want to learn details about replacement circuit board that you mentioned that you are working on. I want to learn the progress and estimated cost of the board. I'm interested in your project and would like to buy. We can also discuss on email if you can provide contact to me.

Best regards

camcamfresh, 2019-04-11:
The first version of the software for the scooter and Android app have been completed (the app is published on the Play Store but is kind of useless without the board).

I was planning to sell a few prototype boxes for testing later this week, however the circuit broad order had a few errors in the design. I will need to redesign and reorder, which will probably set me back 2 weeks. Haven't thought about price too much, but a guess would be around $100.

mast3rshak3055, 2019-05-15:
Cam please email me directly I have the board I really would like to buy a wiring kit from you

Gskill503@gmail.com

pengiundev, 2019-07-04:
Hello, what's the status of the replacement board? I'm ready to buy a few, can you please email me - ang.angelov@protonmail.com

camcamfresh, 2019-07-05:
I will be posting a link to some boxes on eBay in about a week or two; currently waiting on GPS modules to arrive.

Here are some pics of what it will look like:
https://drive.google.com/drive/folders/1dd2pg6sGPYDqgFMyTAVlMUHgA64pFdBQ?usp=sharing

pengiundev, 2019-07-05:
Will it be possible to build a custom app on top of it, will you publish API details on how to communicate with the box?

camcamfresh, 2019-07-05:
I assume you're talking about a mobile application. It is possible, but I have found it very difficult due to my lack of experience in mobile programming.

I am using Particle's Mobile Application to send commands and a third-party notification app called Pushover to receive alerts on my phone; this works on Android and iOS. This is my preferred way for the foreseeable future as it very reliable.

I have created an app on the Google Play store called Scooter Connect, however it is not completely reliable. It crashes frequently and if the application is not opened by the user, then it will not monitor for alerts. I can post the variables required on the Particle Electron for the Android Application to interact with the scooter, but I do not want people to rely on it since the Android application is unreliable. Without help from someone with experience in mobile application development, I do not think the custom app will be finished for a few years (as I will not begin studying this subject until later in my college career).

Particle's API details are here: https://docs.particle.io/reference/device-cloud/api/

pengiundev, 2019-07-05:
Hello, I am willing to do a mobile app as I have a lot of experience as a javascript developer and I can use javascript to develop mobile apps, too.

I can help with the mobile app and I can open-source it, since you've created a great project and it's only honest to contribute back.

If you want to continue on a private conversation, feel free to email me at the email I posted on my first comment.

Can you please tell me what do you want it to have as features?

camcamfresh, 2019-07-06:
It has been a while since I took a look at the code but this is a summary of what I have so far (this is an Android application). There are 5 primary activities: login, device selection, flashing firmware, main activity, and a control activity. There is also one background service.

Login activity takes the users Particle email and password and retrieves an access token from the Cloud.

Directly after logging in, one is directed to the device selection activity, where they can select an online  Particle Electron. Once a device is selected, the application starts a background service that monitor for events of that device - primarily GPS coordinates and alarm alerts.

If the Electron's firmware doesn't have the correct version number, the user is directed to the flash firmware activity, where they can upload pre-compiled compatible firmware to the Electron. The user is then directed back to the main activity.

The main activity is a Google map with the user's current location. If the user is logged in, they will be able to see the logout button and device selection button. If a device is selected, a dashboard will appear on the bottom of the screen with an lock/unlock button, scooter battery level icon, and a button to the control activity. In addition to the dashboard, if a device is selected, two additional buttons will appear under the 'center to user location' button; one to center to the scooter's location and the other sounds the scooter's alarm.

The control activity is a split screen. The top half contains statistics about the scooter; the bottom half is composed of toggle switches that control the scooter (unlock/lock, headlight on/off, eco mode on/off etc.).

The background service starts when a device is selected and stops when the device selection page is opened. When it receives gps data, the service saves the data in an sql lite database stored on the phone. If the main activity is opened and the scooter's location is not available the map will show the last location of the scooter with a different color marker. When it receives an alarm alert, it sends a notification to the user.

I am currently having problems keep the service running when the application is closed.
I also want to show a timestamp when a user presses the scooter's marker on the map. I also would like to give the user the ability to scroll through past GPS locations along with the matching timestamps.

camcamfresh, 2019-07-16:
I currently have two boards for sell on eBay if anyone is still interested.
https://www.ebay.com/itm/163765642620

sproutbrussell, 2019-08-25:
any more for sale?

robbiet480, 2020-03-04:
@camcamfresh Are you planning to put any more on eBay?

Thread 27 (2019-04-08):

Bug in checksum?

ir-fuel, 2019-04-08:
In your docs it says:

Ck0 and Ck1 are the checksum values to confirm the integrity of the message: to calculate this value we add all of the previous bytes together except 0x55 and 0xAA. We then take this sum and preform an XOR operation (^) with the sum and 0xFFFF. The result of this calculation contains Ck1 and Ck0, respectively

However, when I check the code:

```
calc += data;
calc ^= 0xFFFF;
if(calc == (reciever[messagelength - 1] + reciever[messagelength])) recieverindex++;
else recieverindex = 10;
```

You just add the 2 numbers in the incoming data stream. Shouldn't they be OR'ed together with the high byte shift left 8 places as to make an uint16?

Moreover it seems you add those checksum values to the `calc` variable too? Shouldn't they be excluded from the calculation?

camcamfresh, 2019-04-09:
When checking the checksum of the incoming message the order doesn't matter (it's like adding 100 & 10 vs 10 & 100, you'll always get 110 as the sum).

The calc is the calculated the messages check sum from the actual message; we compare this with what the message is telling us the check sum was when it was sent. If they're the same, we assume the message hasn't changed.

camcamfresh, 2019-04-10:
Great catch, I totally misunderstood that! There is no break in that case, so I think the switch was overflowing to the next case causing the bug to go unnoticed. I'll post an update to the code.

kyuhyong, 2019-04-10:
I also checked the code myself and tried to apply the update you made as well as my solutions however, they all not working and only the original code as below can receive data correctly.

```
case 3:
                receiver[receiverMessageIndex] = data;
                calc += data;
                receiverMessageIndex++;
                if(receiverMessageIndex == receiverMessageLength) receiverIndex++;
                break;
            case 4:
                receiver[receiverMessageIndex] = data;
                calc += data;
                calc ^= 0xFFFF;
                if(calc == (receiver[receiverMessageLength - 1] + receiver[receiverMessageLength])) receiverIndex++;
                    else receiverIndex = 10;
```
Have you checked your code with working scooter?

ir-fuel, 2019-04-10:
Just take one message, do the calculations yourself and compare it to the checksum.

example:

`55 aa 04 23 01 1a 34 01 88 ff`
4 + 23 + 1 + 1a + 34 + 1 =  0x77

0x77 ^ 0xFFFF = 0xFF88

What are the last 2 bytes of the command? 0x88 and 0xFF or 0xFF << 8 + 0x88

camcamfresh, 2019-04-10:
I had problems with changing it at first, but eventually got it to work.
The main problem I had was when reading Serial1 I would get the messages sent not the replies. I fixed this by adding the line "if(receiver[3] == 0x20) receiverIndex= 10;" to the end of case 3.

kyuhyong, 2019-04-11:
I tried this one which is pretty much the same as what you proposed, but didn't work.
I didn't try to print each byte and hand calculate them though.

```
case 3:
   receiver[receiverMessageIndex] = data;
   calc += data;
   receiverMessageIndex++;
   if(receiverMessageIndex < receiver[2] + 5) {
calc += data;     //Add data until message index reaches last-1
}
if(receiverMessageIndex == receiver[2] + 6) {//Read until message length
receiverIndex++;
}
if(receiver[3] == 0x20) receiverIndex = 10;
break;
case 4:     //Validate Checksum
receiver[receiverMessageIndex] = data;
calc ^= 0xFFFF;
   if(calc == ((receiver[receiver[2] + 4] + (receiver[receiver[2] + 5] << 8))) ) {
      if(calc == (receiver[receiverMessageLength - 1] + receiver[receiverMessageLength])) {
         receiverIndex++;        //Check sum is correct!
      } else receiverIndex = 10;
```

ir-fuel, 2019-04-11:
your code does not do the shift left operation.

camcamfresh, 2019-04-11:
@kyuhyong in case 5, print to your computer the message packets you receive after the checksum is completed and see if/what the device is reading on Serial1.

Closed 2019-07-05.

Thread 28 (2019-04-11):

Help Finding Connectors for Throttle and Brk

camcamfresh, 2019-04-11:
This isn't directly code related, but I have been searching for weeks to find the same type of connectors that Xiaomi and Seagway use on their controllers with no luck.

I cannot find the 3-pin, 1.5mm female JST connector used for the brake & throttle sensors. I'm thinking I will have the same difficulty searching for the 2-pin 1.5mm female JST connector for the headlight.

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

I have been able to find the male 3-pin JST connector & the cylindrical 4-pin connector, but cannot find the other connectors. Any help in finding these connectors would be appreciated.

aleixdetoro, 2019-10-01:
@camcamfresh Where did you find those connectors? Im struggling with it (specially the cylindrical)... Thanks!

Ursescu, 2019-10-11:
@camcamfresh Hey, can you share the name of the JST connectors ? Are those JST SH ?

andrescli, 2020-09-25:
What is name of the 1.5mm JST throttle connector

andrescli, 2020-09-25:
Please can anyone share the name of the 1.5mm JST throttle connector??

rontav, 2020-10-02:
The connectors used for throttle, brake and the led light are: JST ZHR-3, JST ZMR-03 and JST ZMR-02.
Note that these are the connectors that mate with the ones on the handlebar, aka the connectors used for the dashboard.

Ursescu, 2020-10-02:
The cylindrical one can be found on Aliexpress under the name **Julet Connector**. The original ones I think are called Higo connectors from A&C solutions. [(Here)](https://www.higoconnector.com/products/z209bg-p-00-a0-1000/0999K#title).

Closed 2019-07-05.

Thread 29 (2019-05-13):

Renting Project

zstergios, 2019-05-13:
Hi,
I'm web programmer and 2 years I have spent some time with arduino and electronics.
Your project it's lifesaver. My client wants to rent the scooter like LIME etc.

I can build the APP, the communication api between CONTROLLER->SERVER->MOBILE and backend for management.

I know that there are chinese options out there that I'm thinking it's worth tring to make a demo controller my own.

Still I don't have any Xiami scooter to my hands to able to digg but I'm making a research to be prepared of what I will face.

**So, let's start, please help if the following are right conclusion or wrong**

1)  There 2 power lines 5v & 48v (or 36v), so I don't need regulator to 5v

2) As I read here, the board controller has some pins for output (TX/RX etc) so arduino can write/read via serial

3) firmware.ino seems that I can get/set readings for almost all common renting combabilities

4) Xiami has his own Bluetooth connection. As I know only registered devices (owner) can connect
If not I should disable it.

5) Has some space near to the board controller to add my custom PCB

6) 5V line has over 2 Amps current

Some considerations
I would like to use something that I have worked before like arduino. But has few space, GPS+GSM+ code may it will not have enough ram to do the POST requests.
The other solution is to create a PCB with 2 arduino (bear bones) to double the space  & ram (more tricky)

pilotdeveloper, 2019-05-18:
The Bluetooth is not secure at all and you should absolutely disable that. With that, one could easily replace your main board and walk with your scooter.

Kenner-G, 2019-06-17:
Hello, how did the project go?

Closed 2019-05-18.

Thread 30 (2019-05-13):

Contributor access?

pilotdeveloper, 2019-05-13:
Mind adding me as a contributor?  :)

camcamfresh, 2019-06-23:
Not too knowledgeable about GitHub, but I think changed the settings. Let me know if it worked.

NitroProp, 2019-09-03:
Hi, i would like to contribute by design a new pcb for the project and maybe a new case design. if you want and if there is no difficulty for you we can change the electron with this : https://store.particle.io/collections/cellular/products/e-series-global-3g-module that is more pcb friendly. Let me know if for you is okey
Regards

camcamfresh, 2019-09-06:
I see, it looks good. I use the Electron, so that I can use it other project too (it's really easy to remove with a female header socket). If you integrated this onto the circuit board you wouldn't be able to remove it, but neither would other people. Do you have a picture of the design?

NitroProp, 2019-09-09:
Well right now i'm replicating the board with the Electron but instead of a standard placement on the board, there will be an hole on the pcb shaped like the electron and on the edges there will be solder pads so the board will sit flush with the surface but everithing if thinner and you can acees the sim on the bottom. I've done my best to explain that XD I will keep you updated !

NitroProp, 2020-01-17:
Almost completed the pcb design:
https://drive.google.com/file/d/1tlcTDExb_Qfaydw-JnIANXQ0agfvYybo/view?usp=sharing
waiting to get the other module, in my region is hard to get at the moment, hope you like the pcb design

Thread 31 (2019-06-18):

Anyone encountered sudden voltage drop of 5V from scooter?

kyuhyong, 2019-06-18:
Sorry, this issue has nothing to do with the code itself but I want to share.
I made a board which carries a particle electron board and interface with the scooter.
Main 5V Power is mainly supplied directly from the scooter and has been working although they are not exactly 5V and roughly around 4.8~4.9V measured from multimeter.

The problem is this voltage is not consistent and it can be dropped as low as 4.2V sometime.
This causes  problem maintaining connection with the user.

Has anyone encountered such problem? If so, how did you solve this problem?

camcamfresh, 2019-06-18:
I think I had a problem similar to this. What does the Electron do when you try powering it from only the scooter (without the Electron battery)?

kyuhyong, 2019-06-19:
Thank you for your comment. I found the board won't work if the voltage goes below 4.3V if not powered with the electron battery.
Seems like the regulator on the scooter is limited.

camcamfresh, 2019-06-19:
I had a power issue from the motor controller a while back, but I'm not sure if it's the same problem.

From what I remember, when the Electron battery was not connected the Particle Electron wouldn't connect to a cell tower on start up and the led would pulse white slowly.
If the Electron battery was plugged in, the Electron would connect, but not charge; once the battery was drained enough the Electron led would show it was connected to the cell tower but couldn't actually receive commands through the cloud.

I eventually found a Russian forums page that helped me solve this problem. I had to take out the motor controller, discharge the motor controller (it has capacitors), and solder over a 0 ohms resistor. Take a look at the picture.

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

pilotdeveloper, 2019-06-19:
Please note that touching those capacitors can kill you, so make sure it's
discharged!

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

camcamfresh, 2019-07-05:
@kyuhyong any updates?

kyuhyong, 2019-07-05:
@camcamfresh  Sorry for late reply.
I found the voltage regulator is quite small and highly doubt if it can make over 250mA.
So I decided to put another voltage regulator which can make 5V from 12V in the board as shown below picture.
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

This solved my issue and have not experienced any problem with power.

mossafaei, 2019-08-28:
@kyuhyong  @camcamfresh Hi, Can you show me where is the GND for 12v on the motherboard? This is not clear in the above photo, i can't find it.

camcamfresh, 2019-09-06:
I rarely go into the motor controller's motherboard, but I would assume it is the same as the 5V & 40V GND.
Personally, I would try doing it another way since the capacitors can kill when charged & loose connections happen.

kyuhyong, 2019-10-28:
> @kyuhyong @camcamfresh Hi, Can you show me where is the GND for 12v on the motherboard? This is not clear in the above photo, i can't find it.

All GND is connected with copper ground and to the battery GND as well, so finding is easy if you have any multi-meter at hand.

Closed 2019-07-05.

Thread 32 (2019-07-14):

Headlight doesn't turn on with "headon" command

pengiundev, 2019-07-14:
Hello, I have a problem with the headlight not turning on.

When I use the lock command and move the scooter, the headlight starts to blink but when I use the "headon" command nothing happens. I haven't connected the boost converter because I think that the headlight should be able to work without it just be less visible.

pengiundev, 2019-07-17:
I used a 3.3K resistor and the headlight works now!

Closed 2019-07-17.

Thread 33 (2019-07-17):

Hardware setup throttle resistors info

pengiundev, 2019-07-17:
Hello, can someone explain why we need the second resistor?

> Connect Throttle Input Wire to 1.6K Resistor and the other side of the resistor to Particle Electron's A4 Pin.
> Connect a 3.3K Resistor to the Ground Line and the other side of the resistor to the Particle Electron A4 Pin.
>

camcamfresh, 2019-07-18:
The second resistor completes a voltage divider. The brake/throttle inputs can deliver up to 5V (really 4.9V) when fully pressed; the Electron only reads up to 3.3V (even though the pins are 5V tolerant).

You don't have to implement the voltage divider, but once the input delivers 3.3V or more it won't matter how much further you pull the throttle (or brake) because it will be read at full speed anyways.
From what I remember when testing this, 3.3V delivers an analog read of 4095 on the Electron as does 4.9V. Thinking about it, the Electron might actually read up 4V, but either way your losing some of the range when pressing the brake/throttle sensors.

So if you don't implement the voltage divider, your brake and throttle inputs will only work up to the 3.3V (or 4V) which equates to pulling the lever roughly 2/3 (or 4/5) of it's possible range.

pengiundev, 2019-07-19:
Thank you for the very detailed explanation! It's perfectly clear now :)

Closed 2019-07-19.

Thread 34 (2019-07-24):

How to keep particle on when we power off scooter

arminsalcin, 2019-07-24:
Hello to all ,

So my question is when you turn off scooter by particle the 5V line is 0V so particle is off.
How can you get command from cloud to turn on scooter when 5v line is off ?

mossafaei, 2019-08-07:
You need to use battery when scooter is off

arminsalcin, 2019-08-07:
Thank yoj for answerinf , also question how to keep scooter always in unlocked state ?

mossafaei, 2019-08-09:
https://github.com/camcamfresh/Xiaomi-M365-BLE-Controller-Replacement/issues/19

arminsalcin, 2019-08-10:
Thank you for answering , i already read that but what if scooter is riding and i lock and unlock it by time it will crash. It is little bit risky ...

mossafaei, 2019-08-10:
You can get the state of wheels and checking if scooter is riding or not

arminsalcin, 2019-08-10:
Ok thank you for helping , i figure it out !

Closed 2019-08-10.

Thread 35 (2019-07-29):

How to connect?

mossafaei, 2019-07-29:
Hey
I want to connect wires to my Arduino but descriptions in readme file are not clear for me.
Can anyone send some photos or videos about how to connect wires?
How can i convert this project to Arduino?

mossafaei, 2019-08-07:
Ok, I figured it out

Closed 2019-08-07.

Thread 37 (2019-08-21):

Very strange communication problem. M365

Fcatao1978, 2019-08-21:
Hi guys! I have a real strange battery/ comunication problem. My Battery is almost fully charged and it shows in the app as 3% forever. Even when I go for a ride in the scooter (it reaches only slow speed) the app still show 3%.  I am attaching some pics, is this a board problem? Why my battery blinks a red led when the scooter off? I am new here so I don’t know if this post is in the correct place, sorry.

![Uploading 72B42D14-2802-4B92-925F-F95058AF7ED3.png…]()
![Uploading A6823980-8A9E-47F9-A857-772D02D9F93F.jpeg…]()
![Uploading B1A6AEF2-A7AB-4C98-95C0-2DA76741FAC7.jpeg…]()

Fcatao1978, 2019-08-21:
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

Fcatao1978, 2019-08-21:
I changed the circuit board but the problem continues.

camcamfresh, 2019-09-06:
Which circuit board did you change?
My best guess right now is that something is wrong with the BMS; there is a button on the BMS circuit board (within the plastic), that I believe resets the BMS. I would try that.

Thread 39 (2019-10-12):

M365 connectors

Ursescu, 2019-10-12:
Hey, can you share the name of the JST connectors and the name for the blue connector (4pins)? It can be very useful if someone wants to implement a dashboard replacement.

pengiundev, 2019-10-13:
On the connectors it says JST ZH and XH but I can't find similar looking connectors. Especially cable connectors, not board connectors.

Ursescu, 2019-10-13:
I want to know the name of connectors fort the brake throttle and heading so I can create a plug and play board.

sproutbrussell, 2019-10-16:
Not 100% sure but I think they're 1.5mm pitch, which would make them JST ZH.  JST ZH are also compatible with JST ZR and JST ZM.  Again, not 100% sure, but the trapezoidal 2/3-pin female JSTs on the throttle, brake, and headlight looks like JST ZM:

http://www.jst-mfg.com/product/pdf/eng/eZM.pdf?5da6ba2363b7d
https://en.wikipedia.org/wiki/JST_connector

camcamfresh, 2019-10-17:
Here is where I got the JST connectors: https://order.jst-mfg.com/InternetShop/app/index.php
SAN-002T-0.8A
6P-SAN
4P-SAN
SZH-003T-P0.5
ZHR-3 (PP)
ZMR-02
ZMR-03

I'd need to look for the other connector, idk if I'd be able to find it again.

Honestly, it would probably be easier buying a cheap board and using the connectors on that board (which would require de-soldering and some patience) if you just want a board for yourself

Ursescu, 2019-10-17:
Awesome.

Thank you for your time and information.

For the blue round one, I think it's called Higo connector. But it's annoying that I can't find where to buy them. (some provider link would be awesome).

joeybab3, 2020-06-23:
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

This is an old thread that I stumbled on from google, the round connector is more traditionally known as a "julet" connector and sold under that name or as an "e-bike" connector, but a search for Julet connector should yield the one your looking for.

Ursescu, 2020-06-26:
Closing this issue.

Closed 2020-06-26.

Thread 40 (2019-10-16):

GPS problem: Arduino.h No such file or directory

aleixdetoro, 2019-10-16:
I am trying to run the old_firmware_v6e.ino and procedural_firmware_v9e.ino for using the GPS, the basic_usage.ino already works with my scooter but wihtout the GPS.

When I am adding the NEOGPS Library (including the NMEAsimple.ino, as what I have read in one earlier issue: https://github.com/camcamfresh/Xiaomi-M365-BLE-Controller-Replacement/issues/8) and trying to verify the code, it gives me the following error:

**lib/NeoGPS/NMEAGPS.h:24:21: Arduino.h: No such file or directory**

Did you have the same problem?

Last question, what is exactly the difference between the basic_usage and the other firmwares available apart from the GPS?

Thanks!

camcamfresh, 2019-10-17:
Basic usage was to show how to use the M365 library, but I was having problems with that and haven't had time to look into what was wrong.
I uploaded the old_firmware_v6e.ino, because that was a version that I remember having no known bugs, but the code is kind of messy. The procedural_firmware_v9e.ino is (supposed) to be a cleaner version of v6e, but there are still a few parts that need work (e.g. the headlight stays on when lock).

I will try adding clearer documentation on each file when I have time.

As for the NeoGPS Library, I included the entire library. I'm not sure if the NMEAsimple.ino example includes all of the files. I'd try removing all of the libraries, searching for "NeoGPS" library through Particle's IDE, and click include in project instead of using one of the examples. Let me know how it goes.

adezel, 2019-10-17:
Thanks Cameron! 
Regarding the GPS it hasn't worked. So I have the old_firmware_v6e.ino code,  then I add the NEOGPS library and change from the old_firmware_v6e.ino the "include NeoGPS.h" to "include NMEAGPS.h". It seems in the NEOGPS library the NeoGPS.h does not exist, thats why I have to do that change.

So I get the following error when changing this:
**lib/NeoGPS/NMEAGPS.h:24:21: Arduino.h: No such file or directory**

How did you do it?

By the way can this code work with the Adafruit GPS? Have you tried it adding the ADAFRUIT GPS Library?

camcamfresh, 2019-10-22:
I go to build.particle.io & login; then you would want to create a new app and name it. Before you copy any of the code, I would make sure you select your Electron Particle device under the "Devices" tab. This way when you "Verify" (compile) and "Flash" the code, the IDE knows that you are using the Electron; this way we can #include "Serial5/Serial5.h" without any errors.

Next I would search for the NeoGPS library; it is about 6.8K. Select the library and "Include in Project". This will ask you which project you want to include the library in. Select the app name in the first step and select confirm. This will cause a statement: "#include <NeoGPS.h>" to be added your app. Change this to "#include <NMEAGPS.h>". Verify the your app and make sure it compiles. If successful then you can copy the code from github into your app.

I have only tried using the Neo GPS; I wouldn't see a problem with using the Adafruit GPS assuming there is a Adafruit library for the GPS.

adezel, 2019-11-15:
It finnally worked!

Now the problem appears when getting the FIX from the GPS Module. I have connected the GPS to the 3.3V, GND, C0 and C1, with all the other parts on the PCB , and even if I put the gps outside it does not get a fix position (led blinking).

However when I try just the electron and the GPS module connected with cables, the FIX GPS position is received very fast.

Have you had any trouble with this?

I have read that puting some cap in the VIN-GND of the GPS could solve the problem...

Thread 41 (2019-12-17):

DOES IT WORK FOR XIAOM M365 PRO?

SKajiwara, 2019-12-17:

SKajiwara, 2019-12-19:
Only thing doesn't work is the switch to turn on for me except for "poweron" and "poweroff" because of the D7 output

D7 is the outputs 3.3v to the trangister's base to turn turn on and off by outing 3.3 but it goes 3.3v and 0 repeatedly non stop when I measure the voltage coming out from D7. Is there something wrong with the code?

camcamfresh, 2019-12-27:
Has never been tested, but seems possible

SKajiwara, 2020-01-01:
Thank you

Thread 42 (2019-12-18):

I can not compile. Gives an error message

VadymKC, 2019-12-18:
firmware.ino:9:1: 'PMIC' does not name a type
firmware.ino:331:9: 'pmic' was not declared in this scope
Tell me what to do with this?

VadymKC, 2019-12-18:
I use Photon (Device OS:1.4.4)

camcamfresh, 2019-12-27:
I believe PMIC is only for the Electron, you might be able to use one of the pins on the photon and read the voltage level from there instead. However, you will likely need a battery. If the power turns off, then so does the Photon and you'll have no way to restart the scooter remotely.

VadymKC, 2020-01-24:
Ok

Closed 2020-01-24.

Thread 44 (2020-02-21):

Arduino Nano 33 BLE - Can't send commands

bartoszwarszawa, 2020-02-21:
I am using your procedural_firmware_v9e.ino for reference to make an Arduino Version of this with SIM808 GSM chip aaand the commands don't really work.
I did it the same as you. I am translating the message from the DRV controller put them in stats structure and at the end of the translate function check if the commands are triggered.
Commands are in a command structure as well and even if i hardcode (change) the commands from the default ones when turning on the scooter it doesn't change.
I made a custom function to view the protocol messages comming from DRV controller and i can see that the changes are not triggered. And also when i try to turn on the tail light it doesn't trigger as well. Any idea on fixing it? The code is more or less the same as yours.

bartoszwarszawa, 2020-02-21:
I did downgrade the DRV firmware version to 1.3.4 as in the protocol listed.

technoo10201, 2020-03-01:
Hi @bartoszwarszawa
Where did you find the Timer library ? I'm not able to find it...
Thanks in advance !

Thread 45 (2020-03-01):

Can't find Timer library

technoo10201, 2020-03-01:
Hello @camcamfresh

I'm working with your library M365.h but i'm not able to find Timer.h...
Could you please tell me where i will find it ?

Many thanks in advance !

alekxoo, 2021-07-10:
@bartoszwarszawa Where can I find the Arduino thread?

Closed 2025-10-02.

Thread 46 (2020-03-07):

Is it possible to change max speed using basic_usage.ino?

SKajiwara, 2020-03-07:

bartoszwarszawa, 2020-03-10:
You need to change engine driver with M365 DownG - You need to use original BLE controller for that. There are firmware generators when you can lift engine electric limits. Btw you don't want to do that if you don't know what you're doing. Those engines heat up pretty fast when you exceed 250W on them.

SKajiwara, 2020-03-10:
Thank you for reply.
I see what you mean. I didn't know about the engine.

I am not trying to fasten the scooter too much.
I wonder if I can lower the speed even by subtracting input values from Throttle to a lower value. What do you think?

SKajiwara, 2020-03-10:
Thank you for reply.
I see what you mean. I didn't know about the engine.

I am not trying to fasten the scooter too much.
I wonder if I can lower the speed even by subtracting input values from Throttle to a lower value. What do you think?

bartoszwarszawa, 2020-03-11:
You will loose throttle controll. (By default you have 0-100) if you substract you will press the throttle a little bit and you will not have any input send to the engine. It's better to place higher electric limit on the engine instead because the engine will lower the power of itself and also you will not have issues when  going uphill. (That's the scenario when the engine is doing 2-3x the power and it's heating pretty heavily)

SKajiwara, 2020-03-11:
Ok thank you. I'm not knowledgeable enough to change the electric limit on the motor.

Do you think multiplying 0.8 to throttle can limit speed at 80% of its default max(15.5 miles/hour)??

Thread 47 (2021-02-08):

Schematics

niels-hubs, 2021-02-08:
Hi everyone!

How is the project coming along? It's been a long time since I've seen anyone open / close issues on this matter.

Recently I've seen the project and I'm curious on how everyone progress is coming along. Also I was wondering if there are any drawings / schematics available on the complete part of soldering / tweaking it together.

Thanks and hope to hear from anyone!

Kind regards,
N

Thread 48 (2021-12-28):

need Throttle information of M365

8087482204, 2021-12-28:
I am working on creating a project where i just want to pass throttle signal through arduino to put some conditions about speed and test it.

The problem i am facing is I connected throttle to analog pin of arduino and read the signal using analog.Read function but when i tried to creat same output signal as throttle using arduino's analog.Write function on a digital pin maybe it was not correct as it was not able to rotate the motor.

Is anyone has idea about which type of signal is throttle creating and how can I generate same signal using any arduino's function.

soyalejandroterriza, 2024-04-06:
Did you manage to get it?
