camcamfresh/Xiaomi-M365-BLE-Controller-Replacement/(commit log)

2018-11-07 Create MotorControl
2019-04-10 Update MotorControl
2019-06-23 Project Completely Updated. Removed all files and replaced previous code with M365 class that handles all communication with the scooter. Included basic_usage.ino as an example.
    [M365.cpp, M365.h, basic_usage.ino]
2019-06-23 Fix LED0 & Low Battery Power Switch Error
    [M365.cpp]
2019-06-25 Changed unsigned char's to uint8_t along with some size variables. Then changed battery threshold on the led error state.
    [M365.cpp]
2019-06-25 Changed unsigned char's to uint8_t along with some size variables. Then changed battery threshold on the led error state - Header file changes.
    [M365.h]
2019-06-28 Attempt to fix always-powered-on-error in M365.cpp; added 2 second gap when scooter is turned back on after turning off automatically.
    [M365.cpp]
2019-09-29 Added feature: turns off when M365 battery under 3 percent
2019-09-30 Added known bugs, to be fixed
    [procedural_firmware_v9e.ino]
2019-10-01 Small bugs. Fixed random hard fault and min/max values for brake and throttle.
    [procedural_firmware_v9e.ino]
2019-10-04 Moved isConnected/isPowered out of timer to updateConnections. Added a few comments. Reorganized main.
2019-10-05 Found bug, Electron restarting every few hours
    [procedural_firmware_v9e.ino]
